saravanadinesh/sanjaya/README.md

# Sanjaya
KiCad design for modular sensor gateway
