saravanadinesh/sanjaya/sanjaya.pdf

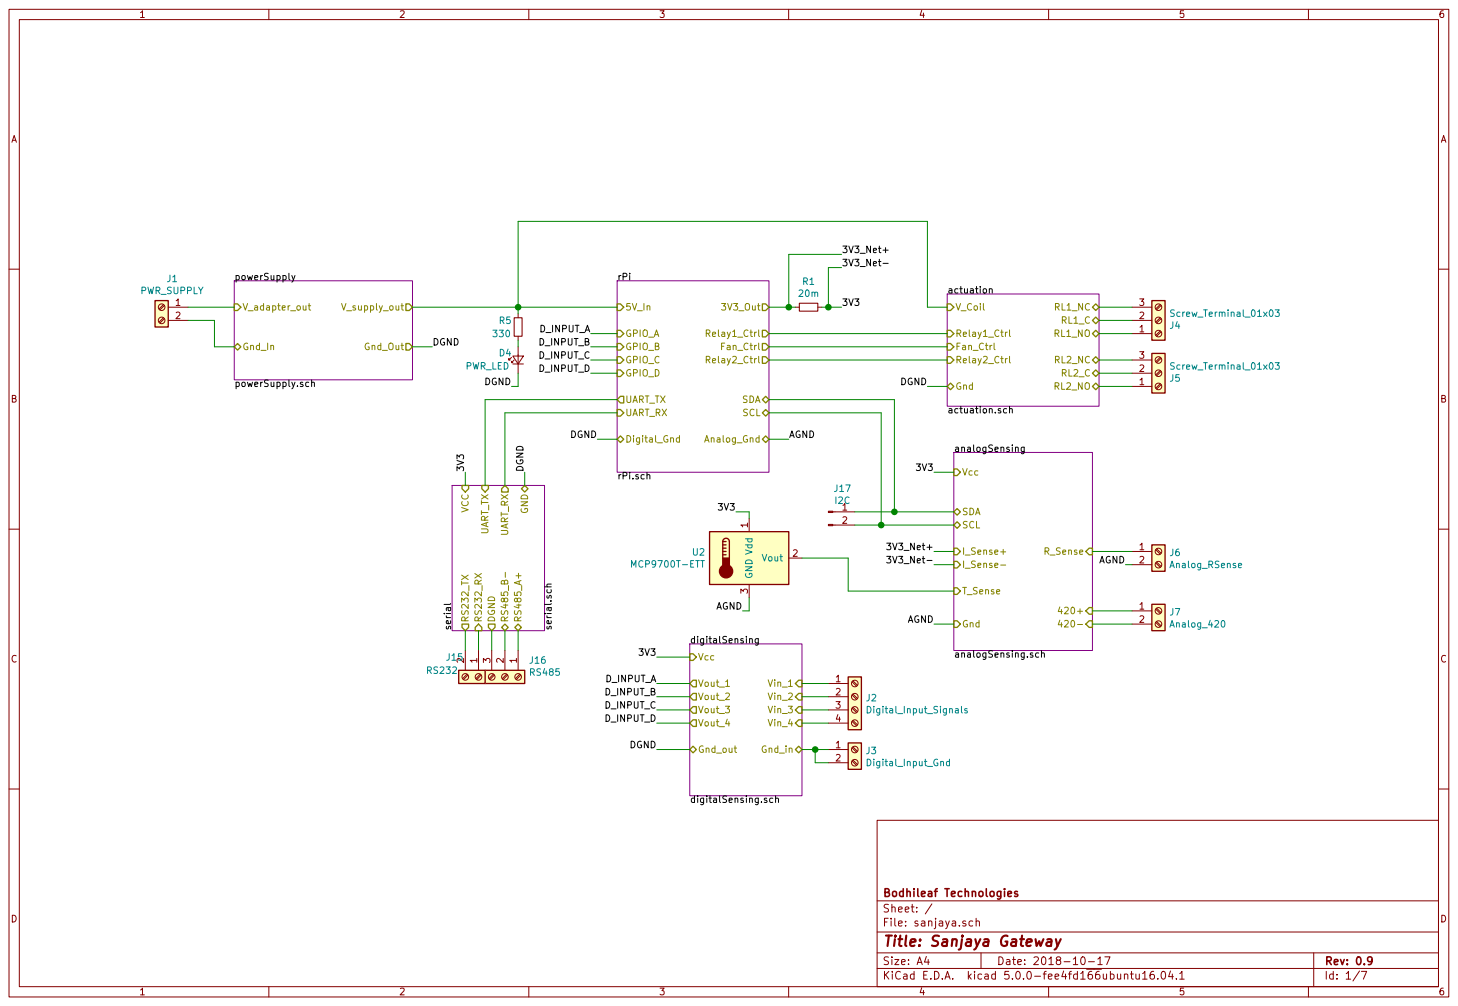
[picture p1: page 1]

File: sanjaya.sch Sheet: / Bodhileaf Technologies

Id: 1/7 Title: Sanjaya Gateway

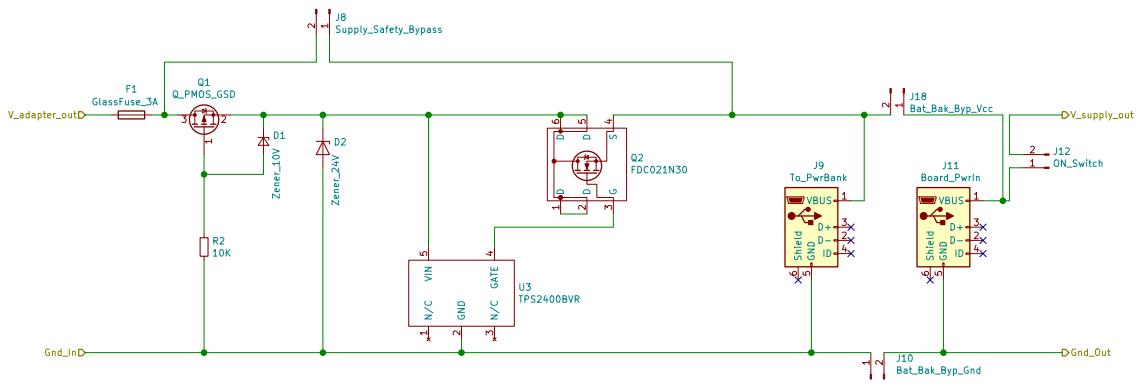
[picture p2: page 2]

Bodhileaf Technologies
Sheet: /powerSupply/
File: powerSupply.sch
Id: 2/7 Title: Power Supply

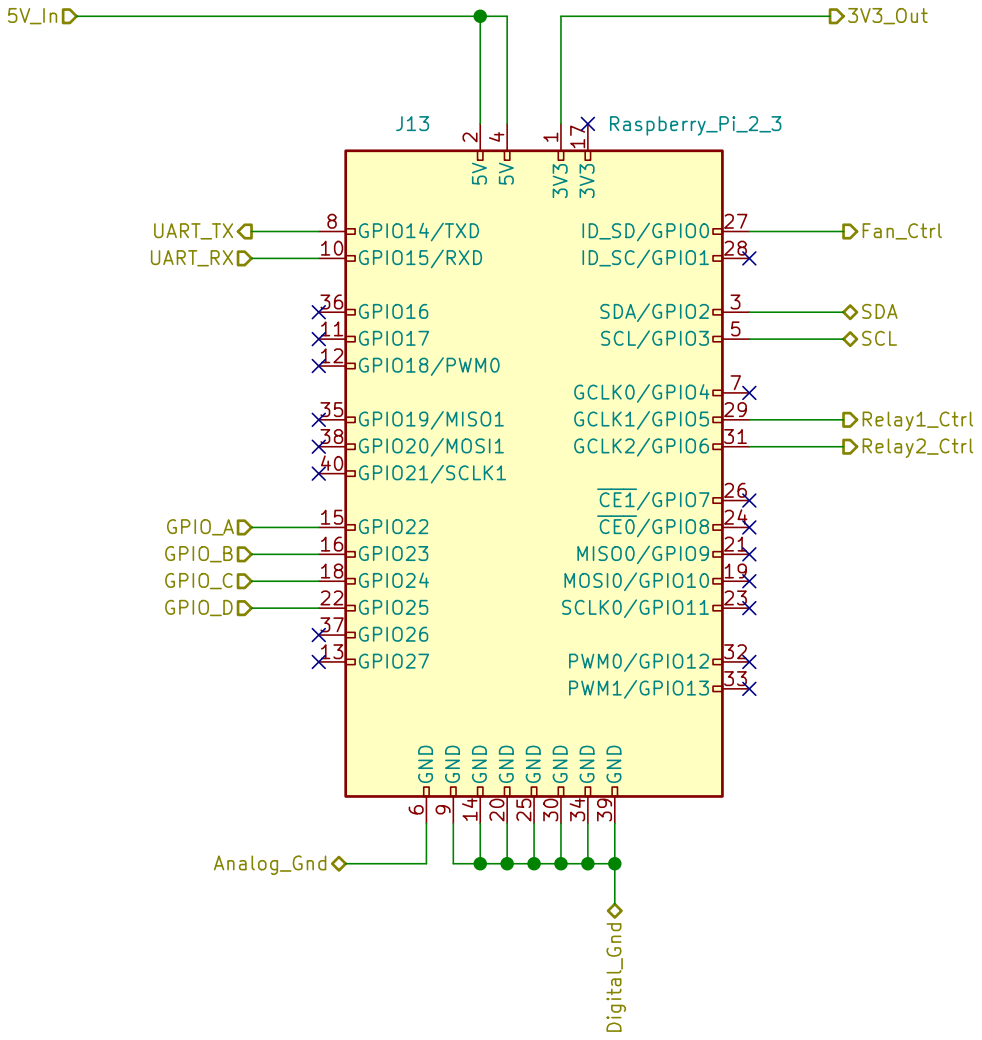
[picture p3: page 3]

Id: 3/7 Title: File: rPi.sch Sheet: /rPi/ Bodhileaf Technologies 3V3

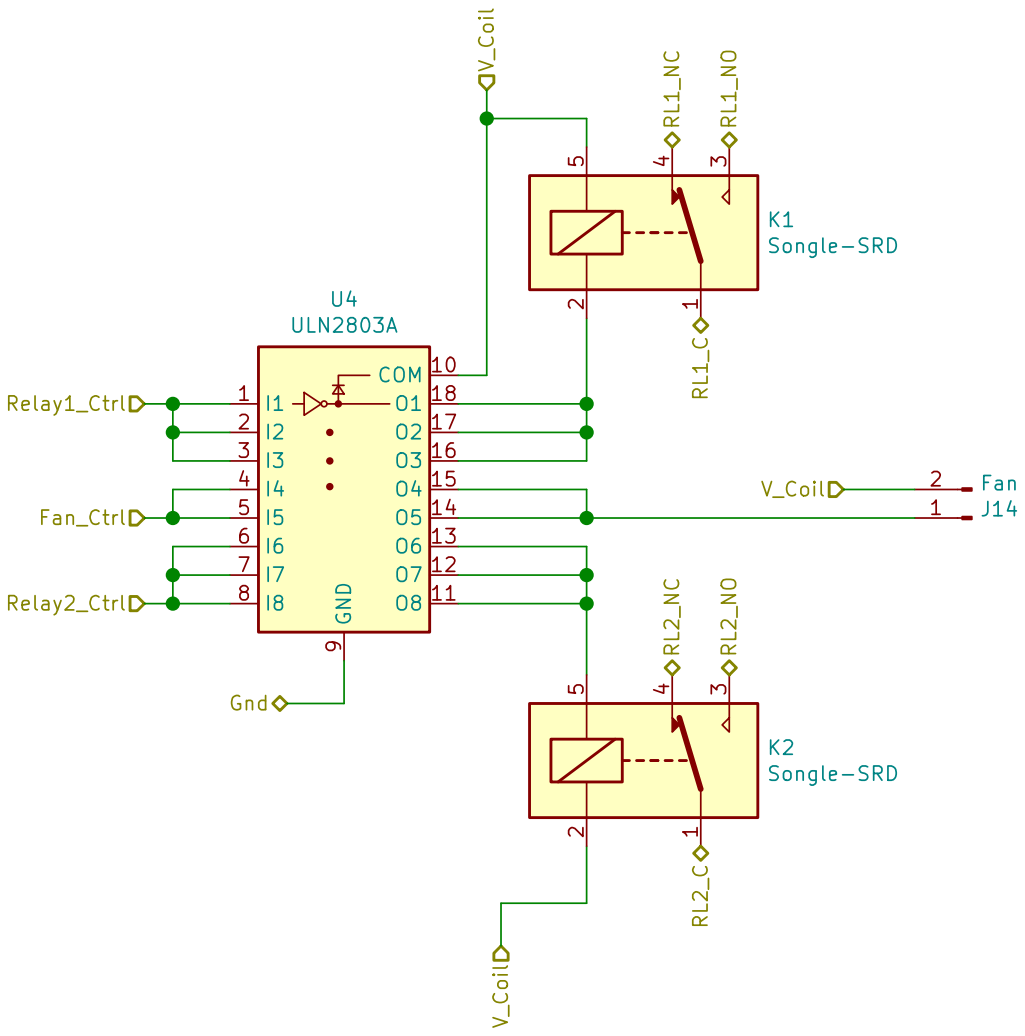
[picture p4: page 4]

Id: 4/7 Title: File: actuation.sch Sheet: /actuation/ Bodhileaf Technologies

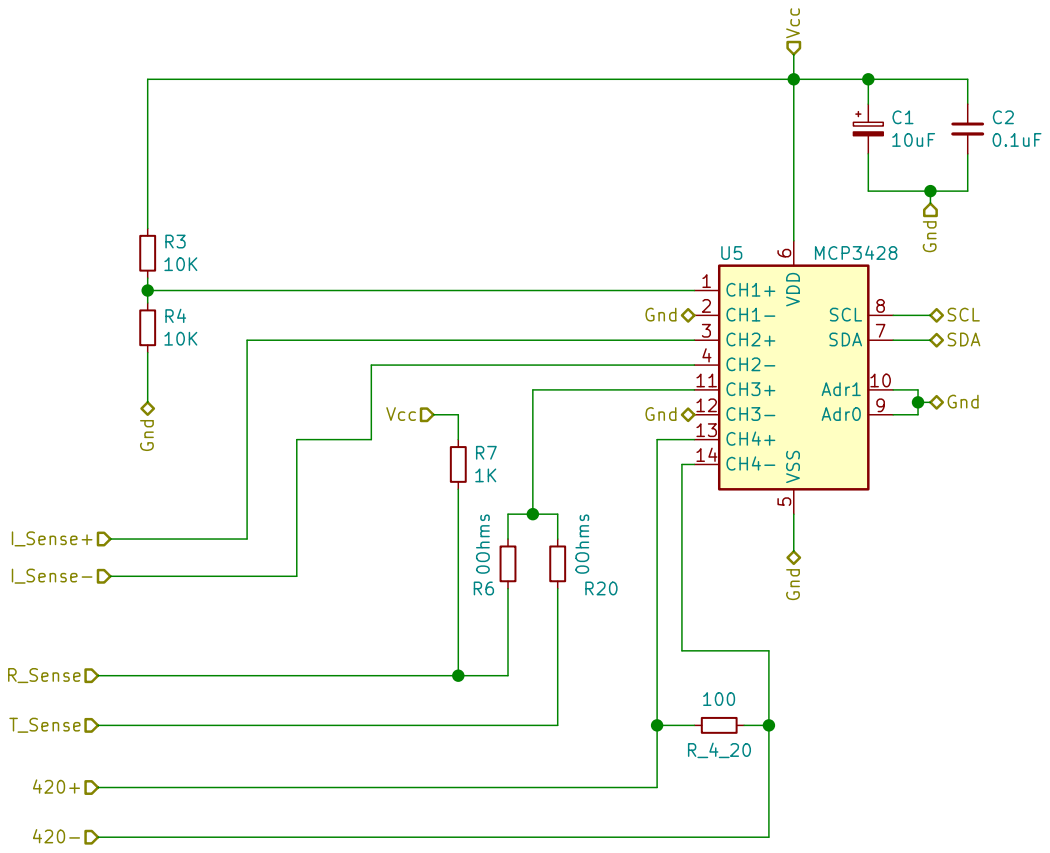
[picture p5: page 5]

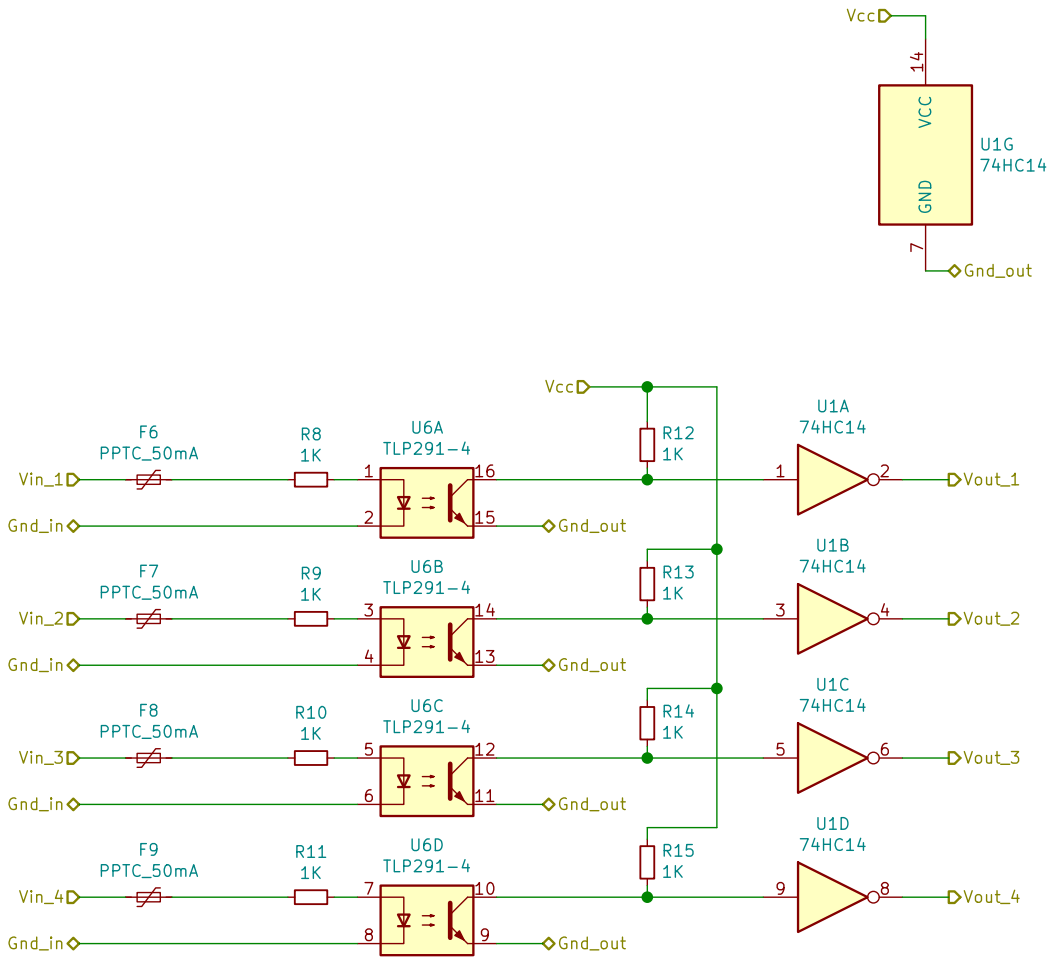
[picture p6: page 6]

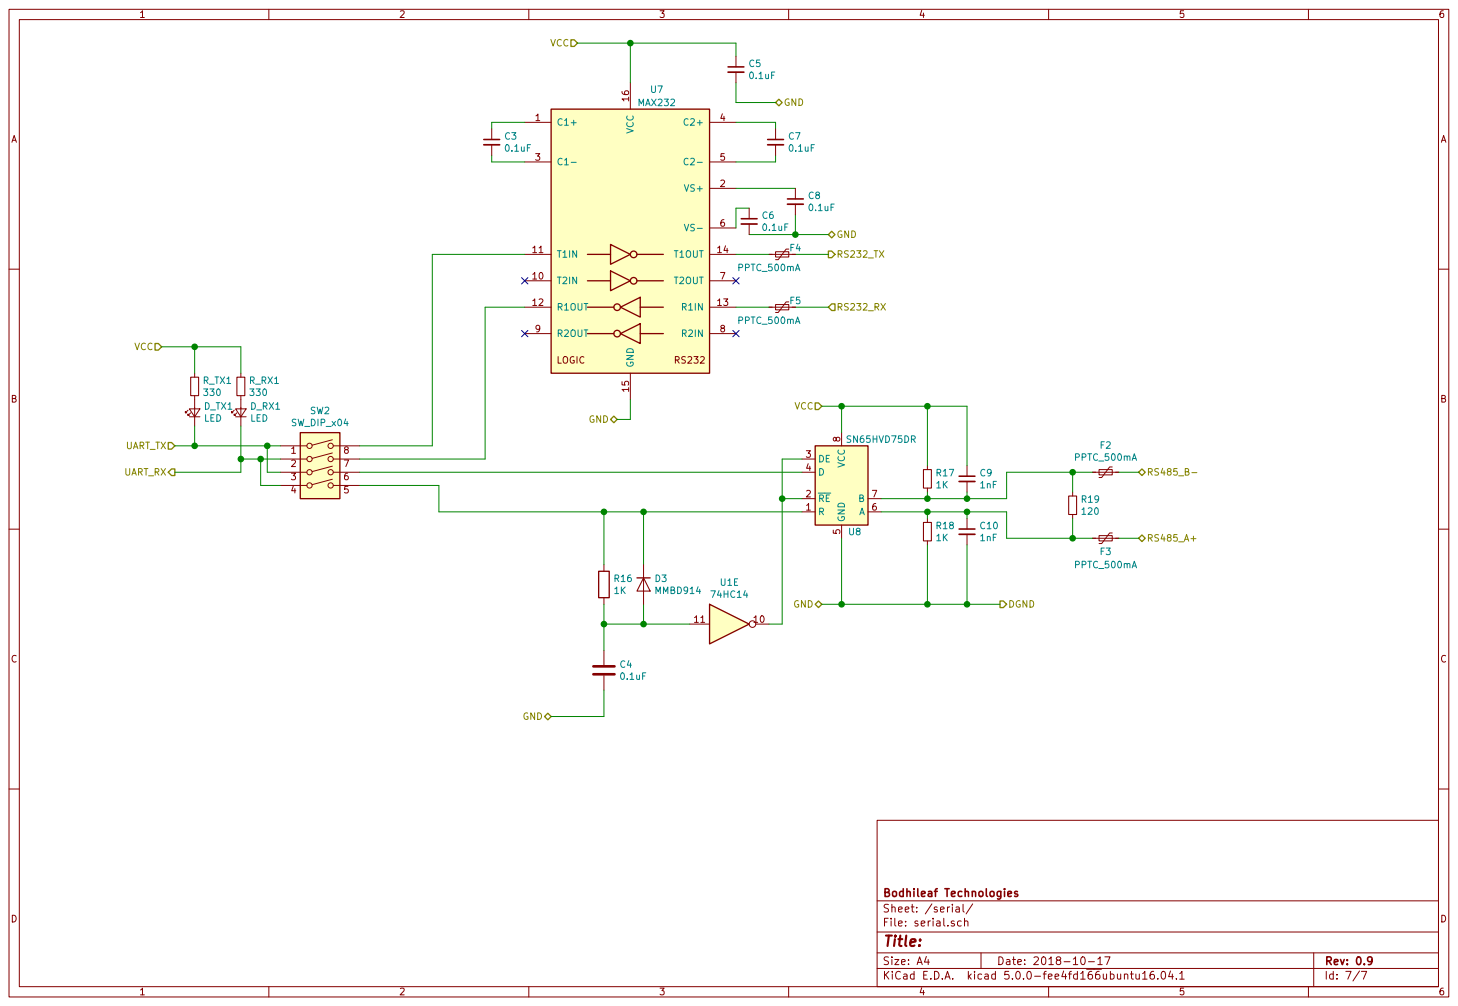
[picture p7: page 7]

Id: 7/7 Title: File: serial.sch Sheet: /serial/ Bodhileaf Technologies
