saravanadinesh/sanjaya/sanjaya.kicad_pcb

## KiCad design sanjaya.kicad_pcb (2018-12-12)

Schematic: sanjaya.sch, Sanjaya Gateway

Parts:
D4: PWR_LED; LED_0805_2012Metric
J1: PWR_SUPPLY; TerminalBlock_Phoenix_MPT-0,5-2-2.54_1x02_P2.54mm_Horizontal
J2: Digital_Input_Signals; TerminalBlock_Phoenix_MPT-0,5-4-2.54_1x04_P2.54mm_Horizontal
J3: Digital_Input_Gnd; TerminalBlock_Phoenix_MPT-0,5-2-2.54_1x02_P2.54mm_Horizontal
J4, J5: Screw_Terminal_01x03; TerminalBlock_Phoenix_MPT-0,5-3-2.54_1x03_P2.54mm_Horizontal
J6: Analog_RSense; TerminalBlock_Phoenix_MPT-0,5-2-2.54_1x02_P2.54mm_Horizontal
J7: Analog_420; TerminalBlock_Phoenix_MPT-0,5-2-2.54_1x02_P2.54mm_Horizontal
J15: RS232; TerminalBlock_Phoenix_MPT-0,5-2-2.54_1x02_P2.54mm_Horizontal
J16: RS485; TerminalBlock_Phoenix_MPT-0,5-3-2.54_1x03_P2.54mm_Horizontal
J17: I2C; JST_EH_B02B-EH-A_1x02_P2.50mm_Vertical
R1: 20m; R_1206_3216Metric
R5: 330; R_0805_2012Metric
U2: MCP9700T-ETT; SOT-23

Connections:
/3V3: R1.1, U2.1 (Vdd); also elsewhere on the board
/3V3_Net+: R1.2; also elsewhere on the board
/AGND: J6.2, U2.3 (GND); also elsewhere on the board
/DGND: D4.1, J16.3; also elsewhere on the board
/actuation/RL1_C: J4.2; also elsewhere on the board
/actuation/RL1_NC: J4.3; also elsewhere on the board
/actuation/RL1_NO: J4.1; also elsewhere on the board
/actuation/RL2_C: J5.2; also elsewhere on the board
/actuation/RL2_NC: J5.3; also elsewhere on the board
/actuation/RL2_NO: J5.1; also elsewhere on the board
/analogSensing/420+: J7.1; also elsewhere on the board
/analogSensing/420-: J7.2; also elsewhere on the board
/analogSensing/R_Sense: J6.1; also elsewhere on the board
/analogSensing/SCL: J17.2; also elsewhere on the board
/analogSensing/SDA: J17.1; also elsewhere on the board
/analogSensing/T_Sense: U2.2 (Vout); also elsewhere on the board
/digitalSensing/Gnd_in: J3.1, J3.2; also elsewhere on the board
/digitalSensing/Vin_1: J2.1; also elsewhere on the board
/digitalSensing/Vin_2: J2.2; also elsewhere on the board
/digitalSensing/Vin_3: J2.3; also elsewhere on the board
/digitalSensing/Vin_4: J2.4; also elsewhere on the board
/powerSupply/Gnd_In: J1.2; also elsewhere on the board
/powerSupply/V_adapter_out: J1.1; also elsewhere on the board
/rPi/5V_In: R5.1; also elsewhere on the board
/serial/RS232_RX: J15.1; also elsewhere on the board
/serial/RS232_TX: J15.2; also elsewhere on the board
/serial/RS485_A+: J16.1; also elsewhere on the board
/serial/RS485_B-: J16.2; also elsewhere on the board
unnamed: D4.2, R5.2

Schematic: powerSupply.sch, Power Supply

Parts:
D1: Zener_10V; D_SOT-23_ANK
D2: Zener_24V; D_SMA
F1: GlassFuse_3A; JST_EH_B02B-EH-A_1x02_P2.50mm_Vertical
J8: Supply_Safety_Bypass; R_0805_2012Metric
J9: To_PwrBank; USB_Micro-B
J10: Bat_Bak_Byp_Gnd; R_0805_2012Metric
J11: Board_PwrIn; USB_Micro-B
J12: ON_Switch; JST_EH_B02B-EH-A_1x02_P2.50mm_Vertical
J18: Bat_Bak_Byp_Vcc; R_0805_2012Metric
Q1: Q_PMOS_GSD; SOT-23
Q2: FDC021N30; SuperSOT-6
R2: 10K; R_0805_2012Metric
U3: TPS2400BVR; SOT-23-5

Connections:
/DGND: J10.2, J11.5; also elsewhere on the board
/powerSupply/Gnd_In: D2.2, J9.5, J10.1, R2.2, U3.2; also elsewhere on the board
/powerSupply/V_adapter_out: F1.2; also elsewhere on the board
/rPi/5V_In: J12.2; also elsewhere on the board
unnamed: D1.1, D2.1, Q1.2, Q2.5, Q2.6, U3.5
unnamed: D1.2, Q1.1, R2.1
unnamed: F1.1, J8.2, Q1.3
unnamed: J11.1, J12.1, J18.1
unnamed: J8.1, J9.1, J18.2, Q2.4
unnamed: Q2.1, Q2.2
unnamed: Q2.3, U3.4

Schematic: rPi.sch

Parts:
J13: Raspberry_Pi_2_3; IDC-Header_2x20_P2.54mm_Vertical

Connections:
/3V3_Net+: J13.1; also elsewhere on the board
/AGND: J13.6; also elsewhere on the board
/DGND: J13.9, J13.14, J13.20, J13.25, J13.30, J13.34, J13.39; also elsewhere on the board
/D_INPUT_A: J13.15; also elsewhere on the board
/D_INPUT_B: J13.16; also elsewhere on the board
/D_INPUT_C: J13.18; also elsewhere on the board
/D_INPUT_D: J13.22; also elsewhere on the board
/actuation/Fan_Ctrl: J13.27; also elsewhere on the board
/actuation/Relay1_Ctrl: J13.29; also elsewhere on the board
/actuation/Relay2_Ctrl: J13.31; also elsewhere on the board
/analogSensing/SCL: J13.5; also elsewhere on the board
/analogSensing/SDA: J13.3; also elsewhere on the board
/rPi/5V_In: J13.2, J13.4; also elsewhere on the board
/rPi/UART_RX: J13.10; also elsewhere on the board
/rPi/UART_TX: J13.8; also elsewhere on the board

Schematic: actuation.sch

Parts:
J14: Fan; JST_EH_B02B-EH-A_1x02_P2.50mm_Vertical
K1, K2: Songle-SRD; Relay_SPDT_SANYOU_SRD_Series_Form_C
U4: ULN2803A; SOIC-18W_7.5x11.6mm_P1.27mm

Connections:
/DGND: U4.9; also elsewhere on the board
/actuation/Fan_Ctrl: U4.4, U4.5; also elsewhere on the board
/actuation/RL1_C: K1.1; also elsewhere on the board
/actuation/RL1_NC: K1.4; also elsewhere on the board
/actuation/RL1_NO: K1.3; also elsewhere on the board
/actuation/RL2_C: K2.1; also elsewhere on the board
/actuation/RL2_NC: K2.4; also elsewhere on the board
/actuation/RL2_NO: K2.3; also elsewhere on the board
/actuation/Relay1_Ctrl: U4.1, U4.2, U4.3; also elsewhere on the board
/actuation/Relay2_Ctrl: U4.6, U4.7, U4.8; also elsewhere on the board
/rPi/5V_In: J14.2, K1.5, K2.2, U4.10; also elsewhere on the board
unnamed: J14.1, U4.14, U4.15
unnamed: K1.2, U4.16, U4.17, U4.18
unnamed: K2.5, U4.11, U4.12, U4.13

Schematic: analogSensing.sch

Parts:
C1: 10uF; CP_EIA-3216-12_Kemet-S
C2: 0.1uF; C_0805_2012Metric
R3, R4: 10K; R_1206_3216Metric
R6, R20: 0Ohms; R_0805_2012Metric
R7: 1K; R_0805_2012Metric
R_4_20: 100; R_1206_3216Metric
U5: MCP3428; SOIC-14_3.9x8.7mm_P1.27mm

Connections:
/3V3: C1.1, C2.1, R3.1, R7.1, U5.4, U5.6; also elsewhere on the board
/3V3_Net+: U5.3; also elsewhere on the board
/AGND: C1.2, C2.2, R4.2, U5.2, U5.5, U5.9, U5.10, U5.12; also elsewhere on the board
/analogSensing/420+: R_4_20.2, U5.13; also elsewhere on the board
/analogSensing/420-: R_4_20.1, U5.14; also elsewhere on the board
/analogSensing/R_Sense: R6.2, R7.2; also elsewhere on the board
/analogSensing/SCL: U5.8; also elsewhere on the board
/analogSensing/SDA: U5.7; also elsewhere on the board
/analogSensing/T_Sense: R20.2; also elsewhere on the board
unnamed: R3.2, R4.1, U5.1
unnamed: R6.1, R20.1, U5.11

Schematic: digitalSensing.sch

Parts:
F6, F7, F8, F9: PPTC_50mA; Fuse_1210_3225Metric
R8, R9, R10, R11, R12, R13, R14, R15: 1K; R_0805_2012Metric
U1: 74HC14; TSSOP-14_4.4x5mm_P0.65mm
U6: TLP291-4; SOP-16_4.4x10.4mm_P1.27mm

Connections:
/3V3: R12.2, R13.2, R14.2, R15.2, U1.14 (VCC); also elsewhere on the board
/DGND: U1.7 (GND), U6.9, U6.11, U6.13, U6.15; also elsewhere on the board
/D_INPUT_A: U1.2; also elsewhere on the board
/D_INPUT_B: U1.4; also elsewhere on the board
/D_INPUT_C: U1.6; also elsewhere on the board
/D_INPUT_D: U1.8; also elsewhere on the board
/digitalSensing/Gnd_in: U6.2, U6.4, U6.6, U6.8; also elsewhere on the board
/digitalSensing/Vin_1: F6.2; also elsewhere on the board
/digitalSensing/Vin_2: F7.2; also elsewhere on the board
/digitalSensing/Vin_3: F8.2; also elsewhere on the board
/digitalSensing/Vin_4: F9.2; also elsewhere on the board
unnamed: F6.1, R8.2
unnamed: F7.1, R9.2
unnamed: F8.1, R10.2
unnamed: F9.1, R11.2
unnamed: R8.1, U6.1
unnamed: R9.1, U6.3
unnamed: R10.1, U6.5
unnamed: R11.1, U6.7
unnamed: R12.1, U1.1, U6.16
unnamed: R13.1, U1.3, U6.14
unnamed: R14.1, U1.5, U6.12
unnamed: R15.1, U1.9, U6.10

Schematic: serial.sch

Parts:
C3, C4, C5, C6, C7, C8: 0.1uF; C_0805_2012Metric
C9, C10: 1nF; C_0805_2012Metric
D3: MMBD914; D_SOT-23_ANK
D_RX1: LED; LED_0805_2012Metric
D_TX1: LED; LED_0805_2012Metric
F2, F3, F4, F5: PPTC_500mA; Fuse_1812_4532Metric
R16, R17, R18: 1K; R_0805_2012Metric
R19: 120; R_0805_2012Metric
R_RX1: 330; R_0805_2012Metric
R_TX1: 330; R_0805_2012Metric
SW2: SW_DIP_x04; SW_DIP_SPSTx04_Slide_KingTek_DSHP04TJ_W5.25mm_P1.27mm_JPin
U1: 74HC14; TSSOP-14_4.4x5mm_P0.65mm
U7: MAX232; TSSOP-16_4.4x5mm_P0.65mm
U8: SN65HVD75DR; SOIC-8_3.9x4.9mm_P1.27mm

Connections:
/3V3: C5.1, C9.1, R17.1, R_RX1.1, R_TX1.1, U7.16, U8.8 (VCC); also elsewhere on the board
/DGND: C4.2, C5.2, C6.2, C8.2, C10.2, R18.2, U7.15, U8.5 (GND); also elsewhere on the board
/rPi/UART_RX: D_RX1.1, SW2.2, SW2.4; also elsewhere on the board
/rPi/UART_TX: D_TX1.1, SW2.1, SW2.3; also elsewhere on the board
/serial/RS232_RX: F5.1; also elsewhere on the board
/serial/RS232_TX: F4.1; also elsewhere on the board
/serial/RS485_A+: F3.1; also elsewhere on the board
/serial/RS485_B-: F2.1; also elsewhere on the board
unnamed: C3.1, U7.1
unnamed: C3.2, U7.3
unnamed: C4.1, D3.2 (A), R16.2, U1.11
unnamed: C6.1, U7.6
unnamed: C7.1, U7.4
unnamed: C7.2, U7.5
unnamed: C8.1, U7.2
unnamed: C9.2, F2.2, R17.2, R19.1, U8.7 (B)
unnamed: C10.1, F3.2, R18.1, R19.2, U8.6 (A)
unnamed: D3.1 (K), R16.1, SW2.6, U8.4 (D)
unnamed: D_RX1.2, R_RX1.2
unnamed: D_TX1.2, R_TX1.2
unnamed: F4.2, U7.14
unnamed: F5.2, U7.13
unnamed: SW2.5, U8.1 (R)
unnamed: SW2.7, U7.12
unnamed: SW2.8, U7.11
unnamed: U1.10, U8.2 (~RE), U8.3 (DE)

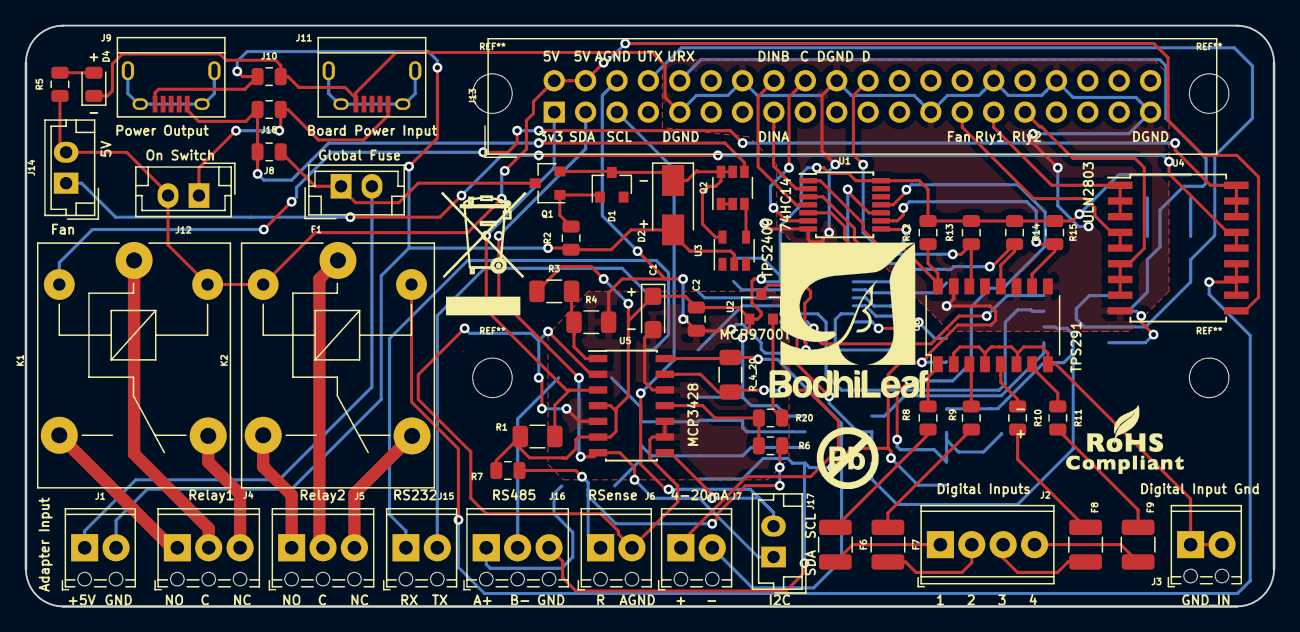
[picture p8: board sanjaya.kicad_pcb from above]

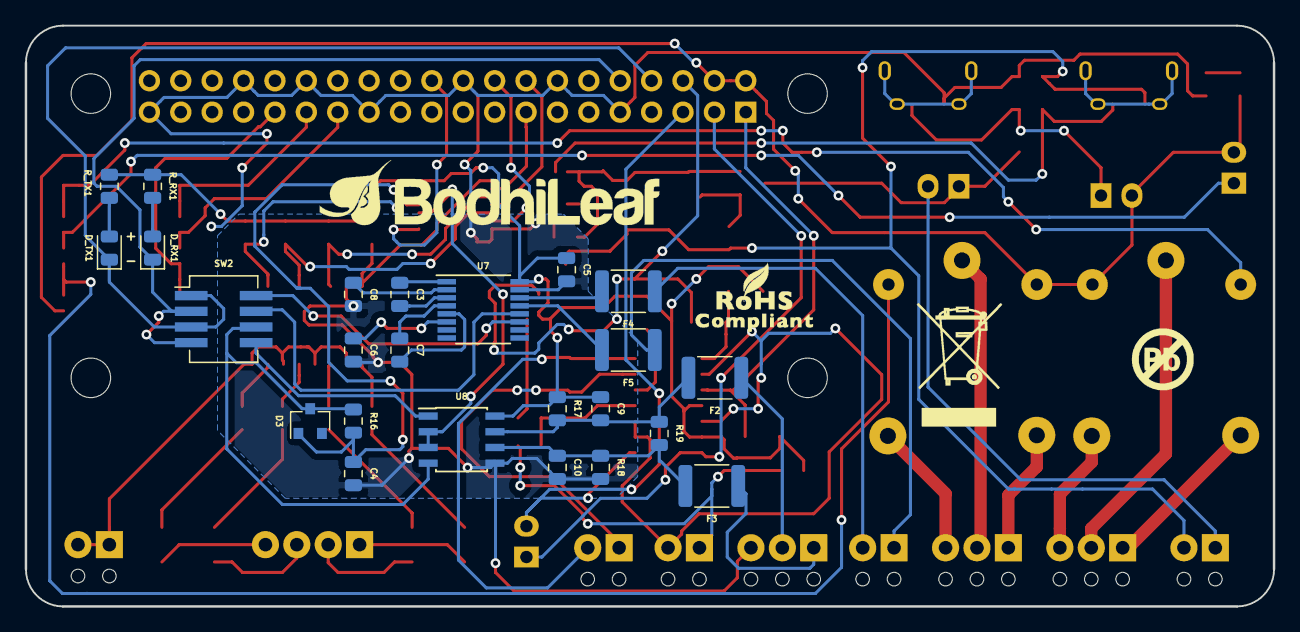
[picture p9: board sanjaya.kicad_pcb from below]

Board: 2 copper layers, 101.0 x 47.0 mm, 79 parts (24 on the bottom side), 80 nets.
