saravanadinesh/sanjaya/(commit log)

2018-09-26 First Commit. Contains: 1. Schematics empty tree except for power supply design
    [actuation.sch, analogSensing.sch, digitalSensing.sch, powerSupply.sch, rPi.sch, sanjaya.kicad_pcb, sanjaya.sch, serial.sch]
2018-09-29 Changes: 1. Serial (RS232, 485) circuit added.
    [actuation.sch, analogSensing.sch, digitalSensing.sch, powerSupply.sch, rPi.sch, sanjaya.sch, serial.sch]
2018-09-29 Changes: 1. Digital sensing circuit added.
    [actuation.sch, analogSensing.sch, digitalSensing.sch, powerSupply.sch, rPi.sch, sanjaya.sch, serial.sch]
2018-09-30 Changes: 1. Relay and partial analog sensing circuitry added.
    [actuation.sch, analogSensing.sch, sanjaya.sch]
2018-10-01 Changes: 1. Added Analog circuitry
    [actuation.sch, analogSensing.sch, digitalSensing.sch, powerSupply.sch, rPi.sch, sanjaya.sch, serial.sch]
2018-10-02 Changes: 1. RPi hierarchial sheet populated with appropriate circuit 2. Wiring hierarchial sheets together completed except for the temperature sensor
    [actuation.sch, analogSensing.sch, digitalSensing.sch, powerSupply.sch, rPi.sch, sanjaya.sch, serial.sch]
2018-10-02 Changes: 1. Added temperature sensor 2. Wired it to the rest of the circuit making this the first full-fledged schematic
    [actuation.sch, analogSensing.sch, digitalSensing.sch, powerSupply.sch, rPi.sch, sanjaya.sch, serial.sch]
2018-10-03 Changes: 1. Added all component footprints
    [actuation.sch, analogSensing.sch, digitalSensing.sch, powerSupply.sch, rPi.sch, sanjaya.sch, serial.sch]
2018-10-04 Changes: 1. Removed TVS diodes in favour of a RS485 transceiver of the same footprint that contains ESD protection 2. Tried different layouts.
    [analogSensing.sch, rPi.sch, sanjaya.kicad_pcb, sanjaya.sch, serial.sch]
2018-10-05 Changes: 1. Some net names, connector names changed to be more meaningful 2. I2C connector added 3. Mistake in power bank bypass connection rectified 4. Layout changed. Almost finalized.
    [actuation.sch, analogSensing.sch, digitalSensing.sch, powerSupply.sch, rPi.sch, sanjaya.kicad_pcb, sanjaya.sch, serial.sch]
2018-10-06 Changes: 1. Laid out the ADC part 2. Removed an unnecessary 10K resistor in the ADC voltage sense part
    [analogSensing.sch, sanjaya.kicad_pcb]
2018-10-07 More layout done
    [sanjaya.kicad_pcb]
2018-10-11 Changes: 1. Added a power LED 2. Added PPTC to the inputs of optocoupler 3. Added PPTC to the transceiver side of the RS232 driver 4. Corrected ADC footprint
    [analogSensing.sch, digitalSensing.sch, powerSupply.sch, sanjaya.csv, sanjaya.kicad_pcb, sanjaya.sch, serial.sch]
2018-10-15 Screw connectors footprint changed to 2.54mm ones and relayout done for all terminal blocks
    [actuation.sch, rPi.sch, sanjaya.kicad_pcb, sanjaya.sch]
2018-10-16 Changed USB footprints and did some more routing
    [powerSupply.sch, sanjaya.kicad_pcb]
2018-10-16 Some more routing done. Only 3-4 nets remaining to be routed
    [powerSupply.sch, sanjaya.kicad_pcb]
2018-10-16 All routing done. DRC is passing. NPTH and edge cut are the only things remaining.
    [sanjaya.kicad_pcb]
2018-10-17 Changes: 1. NPTH, Edge cuts added 2. Labels for connectors added 3. DRC is passing
    [sanjaya.kicad_pcb]
2018-10-17 Changes: 1. Finalized layout after adding logo, symbols, labels, polarity 2. Changed version to 0.9 on all sch files.
    [actuation.sch, analogSensing.sch, digitalSensing.sch, powerSupply.sch, rPi.sch, sanjaya.kicad_pcb, sanjaya.sch, serial.sch]
2018-10-18 Changes: 1. Added CE logo to the front and back of the board 2. Plotted gerber files.
    [sanjaya-B.CrtYd.gbr, sanjaya-B.Cu.gbr, sanjaya-B.Mask.gbr, sanjaya-B.Paste.gbr, sanjaya-B.SilkS.gbr, sanjaya-Edge.Cuts.gbr, sanjaya-F.CrtYd.gbr, sanjaya-F.Cu.gbr]
2018-12-12 Changes: 1. Corrected RS485 circuit connections 2. Added silk screen labels and labels to schematics
    [actuation.sch, analogSensing.sch, digitalSensing.sch, powerSupply.sch, rPi.sch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]
2018-12-12 Added some more labels to schematics
    [powerSupply.sch, serial.sch]
